Divyanshu-md/Sanjeevani-Rover/battery_tray.stl

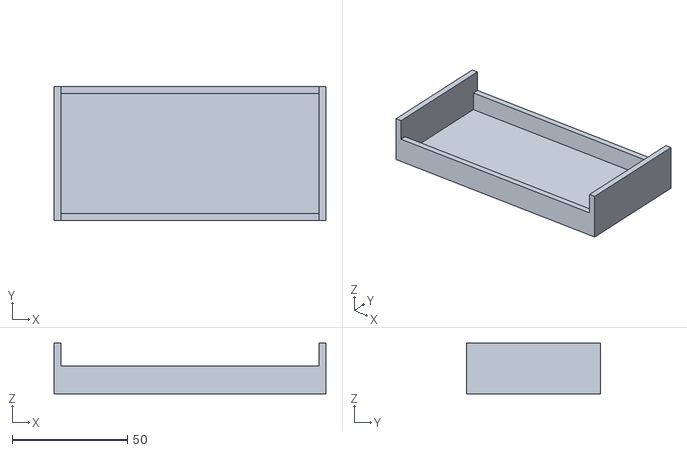
[picture p1: CAD file, 2026-10-22, last stored version]
battery_tray.stl
118.0 x 58.0 x 22.0
