Divyanshu-md/Sanjeevani-Rover/base_plate.stl

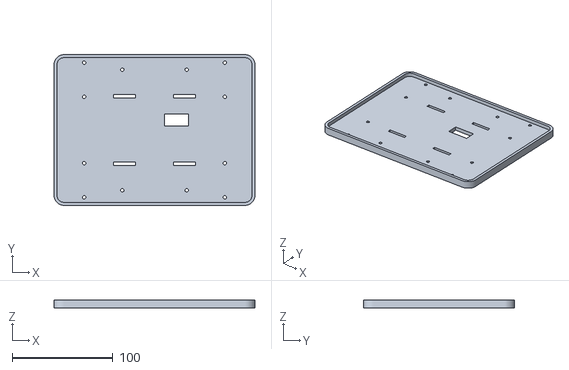
[picture p2: CAD file, 2026-10-22, last stored version]
base_plate.stl
200.0 x 150.0 x 8.00
