Divyanshu-md/Sanjeevani-Rover/gps_mast.stl

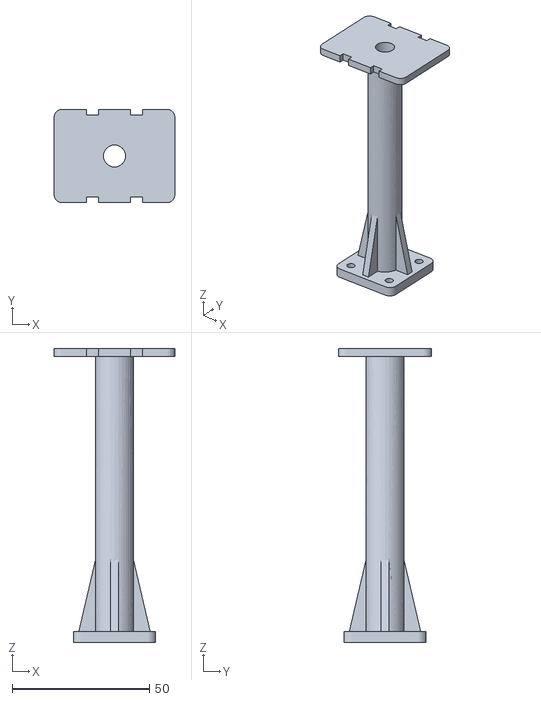
[picture p3: CAD file, 2026-10-22, last stored version]
gps_mast.stl
44.0 x 34.0 x 107.0
