Divyanshu-md/Sanjeevani-Rover/motor_clamp.stl

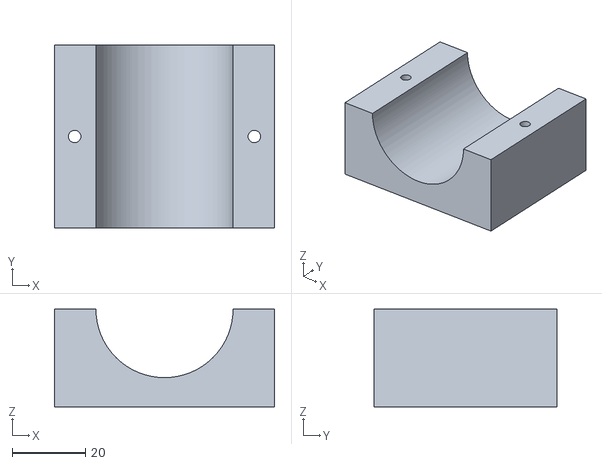
[picture p4: CAD file, 2026-10-22, last stored version]
motor_clamp.stl
60.0 x 50.0 x 26.7
