Divyanshu-md/Sanjeevani-Rover/camera_head.stl

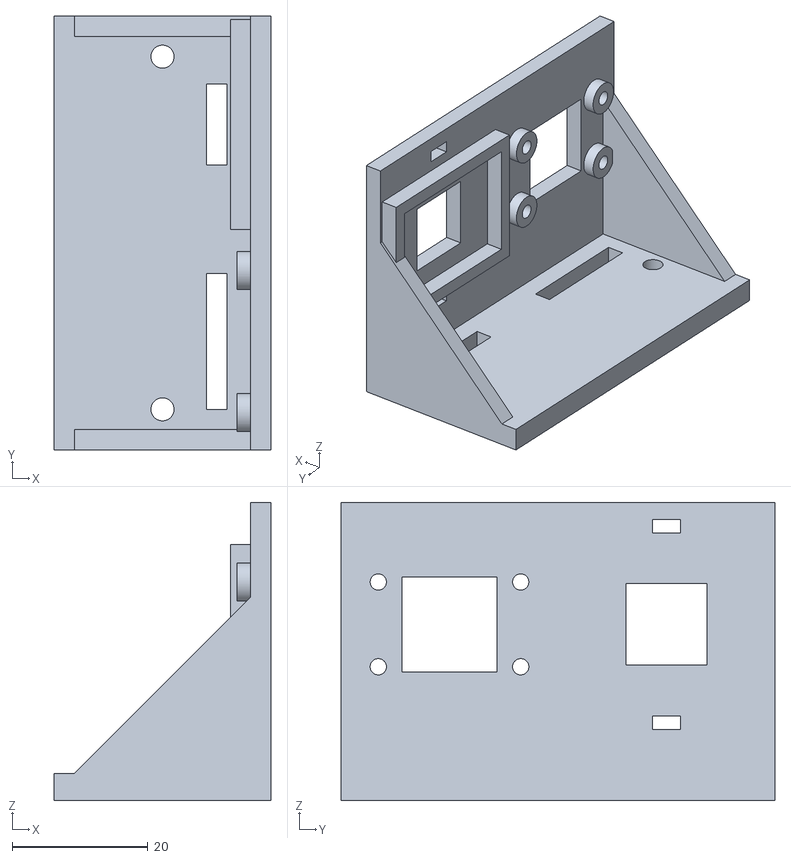
[picture p5: CAD file, 2026-10-22, last stored version]
camera_head.stl
32.0 x 64.0 x 44.0
