Divyanshu-md/Sanjeevani-Rover/standoff_pillar.stl

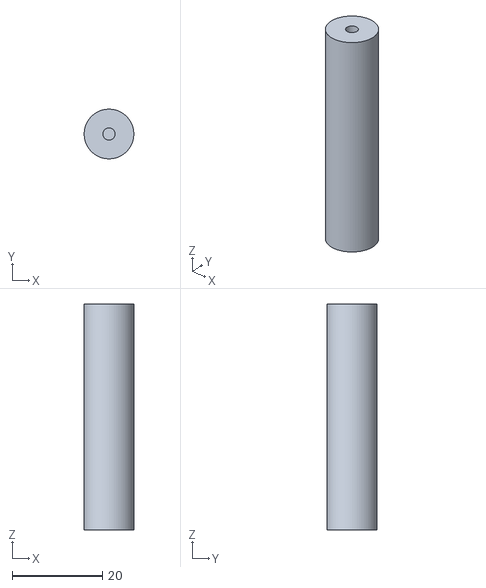
[picture p6: CAD file, 2026-10-22, last stored version]
standoff_pillar.stl
11.0 x 11.0 x 50.0
