Divyanshu-md/Sanjeevani-Rover/motor_cradle.stl

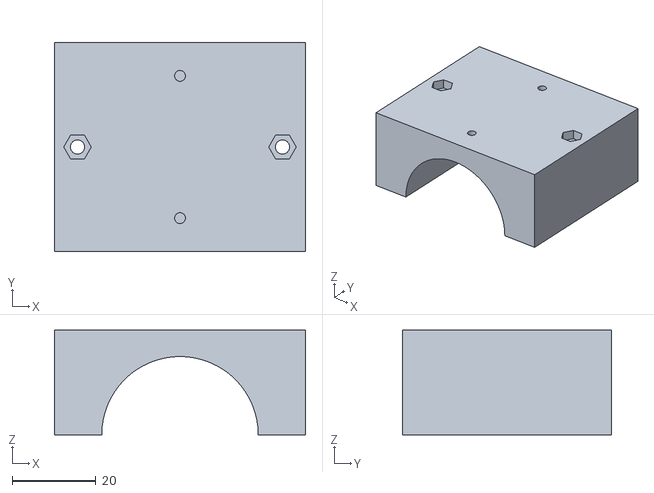
[picture p7: CAD file, 2026-10-22, last stored version]
motor_cradle.stl
60.0 x 50.0 x 25.0
