Divyanshu-md/Sanjeevani-Rover/wheel.stl

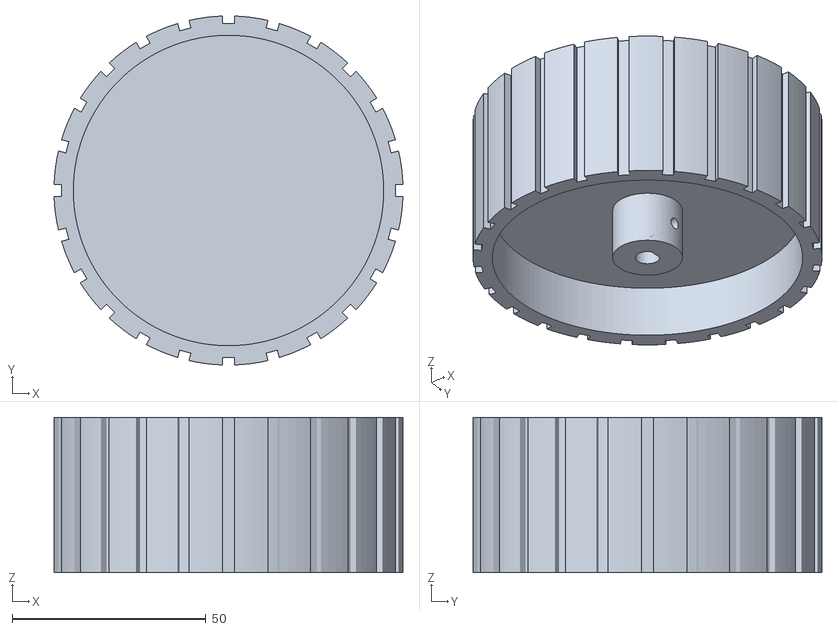
[picture p8: CAD file, 2026-10-22, last stored version]
wheel.stl
89.9 x 89.9 x 40.0
