Divyanshu-md/Sanjeevani-Rover/deck_plate.stl

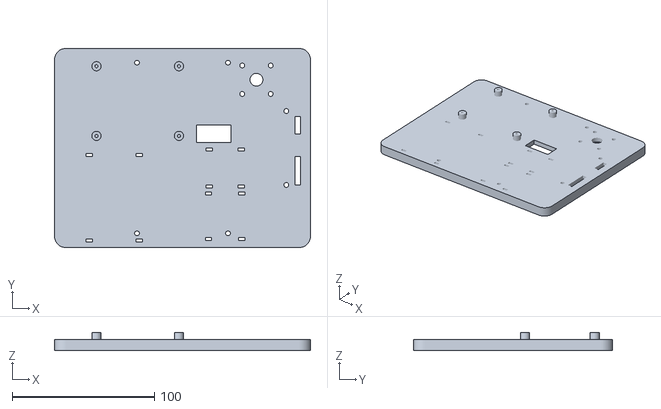
[picture p9: CAD file, 2026-10-22, last stored version]
deck_plate.stl
180.0 x 140.0 x 13.0
